Normansrule/terrific-tpu/experiments/results/e1_speedup.csv

program | v1_cycles | v2_cycles
Neural net | 92 | 77
Fourier | 69 | 61
Image filter | 306 | 291
Quantum search | 128 | 123
Graph triangles | 207 | 163
random 1 | 89 | 78
random 2 | 72 | 56
random 3 | 109 | 93
random 4 | 49 | 48
random 5 | 120 | 104
random 6 | 65 | 59
random 7 | 93 | 80
random 8 | 104 | 94
random 9 | 68 | 64
random 10 | 112 | 75
random 11 | 113 | 82
random 12 | 169 | 130
random 13 | 155 | 145
random 14 | 73 | 67
random 15 | 124 | 99
random 16 | 114 | 99
random 17 | 100 | 69
random 18 | 176 | 130
random 19 | 96 | 94
random 20 | 149 | 122
random 21 | 133 | 99
random 22 | 64 | 45
random 23 | 73 | 58
random 24 | 75 | 73
random 25 | 90 | 87
random 26 | 102 | 87
random 27 | 67 | 61
random 28 | 134 | 111
random 29 | 138 | 108
random 30 | 139 | 118
random 31 | 64 | 58
random 32 | 75 | 45
random 33 | 80 | 61
random 34 | 71 | 63
random 35 | 82 | 69
random 36 | 53 | 52
random 37 | 147 | 113
random 38 | 67 | 48
random 39 | 125 | 106
random 40 | 75 | 67
random 41 | 60 | 52
random 42 | 79 | 77
random 43 | 58 | 46
random 44 | 83 | 79
random 45 | 107 | 102
random 46 | 76 | 54
random 47 | 103 | 95
random 48 | 120 | 108
random 49 | 132 | 103
random 50 | 89 | 82
random 51 | 88 | 78
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
