Normansrule/terrific-tpu/experiments/results/e2_quantization.csv

bits | ideal_error | ideal_top1 | ideal_shift | tinytpu_error | tinytpu_top1 | tinytpu_shift
2 | 1.0000 | 0.072 | 2 | 1.0000 | 0.072 | 2
3 | 0.9429 | 0.110 | 4 | 0.9429 | 0.110 | 4
4 | 0.4768 | 0.534 | 5 | 0.4768 | 0.534 | 5
5 | 0.2158 | 0.798 | 6 | 0.2158 | 0.798 | 6
6 | 0.1073 | 0.920 | 7 | 0.1073 | 0.920 | 7
7 | 0.0565 | 0.978 | 8 | 0.0342 | 0.986 | 7
8 | 0.0269 | 0.988 | 9 | 0.1326 | 0.970 | 7
