Normansrule/terrific-tpu/experiments/results/e5_scaling.csv

N | v1_cycles | v2_cycles | v2_utilization
2 | 74755 | 71686 | 0.914
4 | 20227 | 18442 | 0.888
8 | 5827 | 4882 | 0.839
16 | 1843 | 1378 | 0.743
32 | 655 | 466 | 0.549
64 | 262 | 262 | 0.244
