Normansrule/terrific-tpu/(commit log)

2026-09-25 terrific-tpu: TinyTPU v1 + v2, apps, experiments, 3-D visuals
    [e1_speedup.csv, e2_quantization.csv, e3_energy.csv, e4_utilization.csv, e5_scaling.csv, synth.csv]
2026-09-26 3-D chip tour, challenges, new design system, screenshots
    [synth.csv]
2026-09-28 Research library, lessons 19-20, experiment 6 (sparsity), references
    [e6_sparsity.csv]
2026-09-30 Cycle-exact v2 model in the browser (chip, waves, compiler), quiz with printable worksheet
2026-09-30 Host port on both chips, UART wrapper + testbench, FPGA host tool, ECP5 report, lesson 21
    [fpga.csv]
2026-10-02 Digilent Basys 3 build: self-checking demos, step/slow clock, LEDs + display, virtual board, lesson 22
    [basys3.csv]
2026-10-05 Basys 3: live VGA monitor view (verified frames), virtual monitor, lesson 22 update
    [basys3.csv]
