Normansrule/terrific-tpu/(notices)

Notices in the files:
README.md:
License: MIT
